rallepalaveev/AppleII-VGA/A2VGA2/HW/A2VGA.v2.1.jpeg

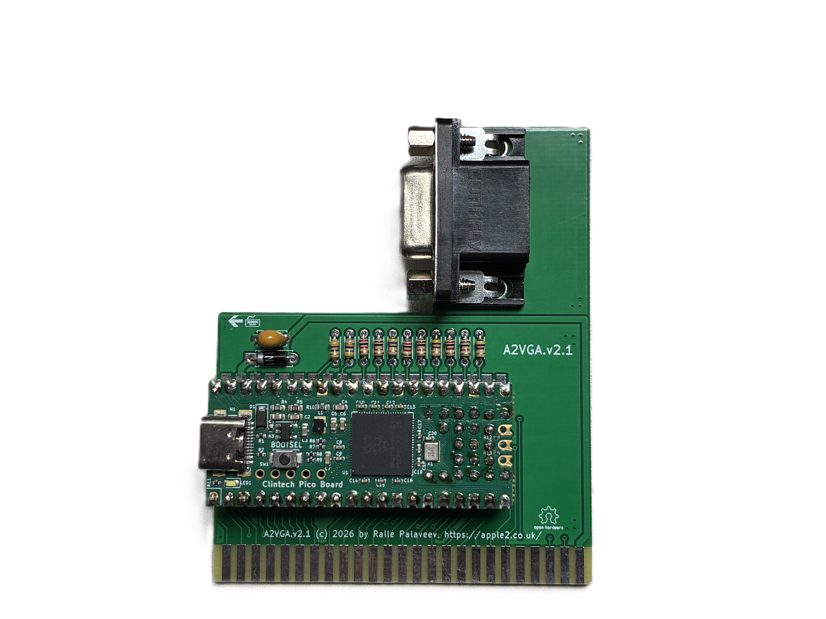
A2VGA2/HW/A2VGA.v2.1.jpeg
