rallepalaveev/AppleII-VGA/A2VGA2/README.md

This is a redesign of the Apple II VGA based on the PR2350 chip with 48 GPIOs (on Clintech Pico Board) which is 5V tolerant and hence no trinsceivers would be needed.

The A2VGA2 hardware design is released under the MIT License:

    Board design by Ralle Palaveev, Copyright (c) 2026.

    Firmware adaptation for RP2350 by Oliver Schmidt, Copyright (c) 2026.

The firmware project would be based on awesome work from the following Apple II VGA project:

    AppleII-VGA. MIT License. Copyright (c) 2021-2022 Mark Aikens.
