rallepalaveev/AppleII-VGA/A2VGA2/HW/A2VGA.v2.0.pdf

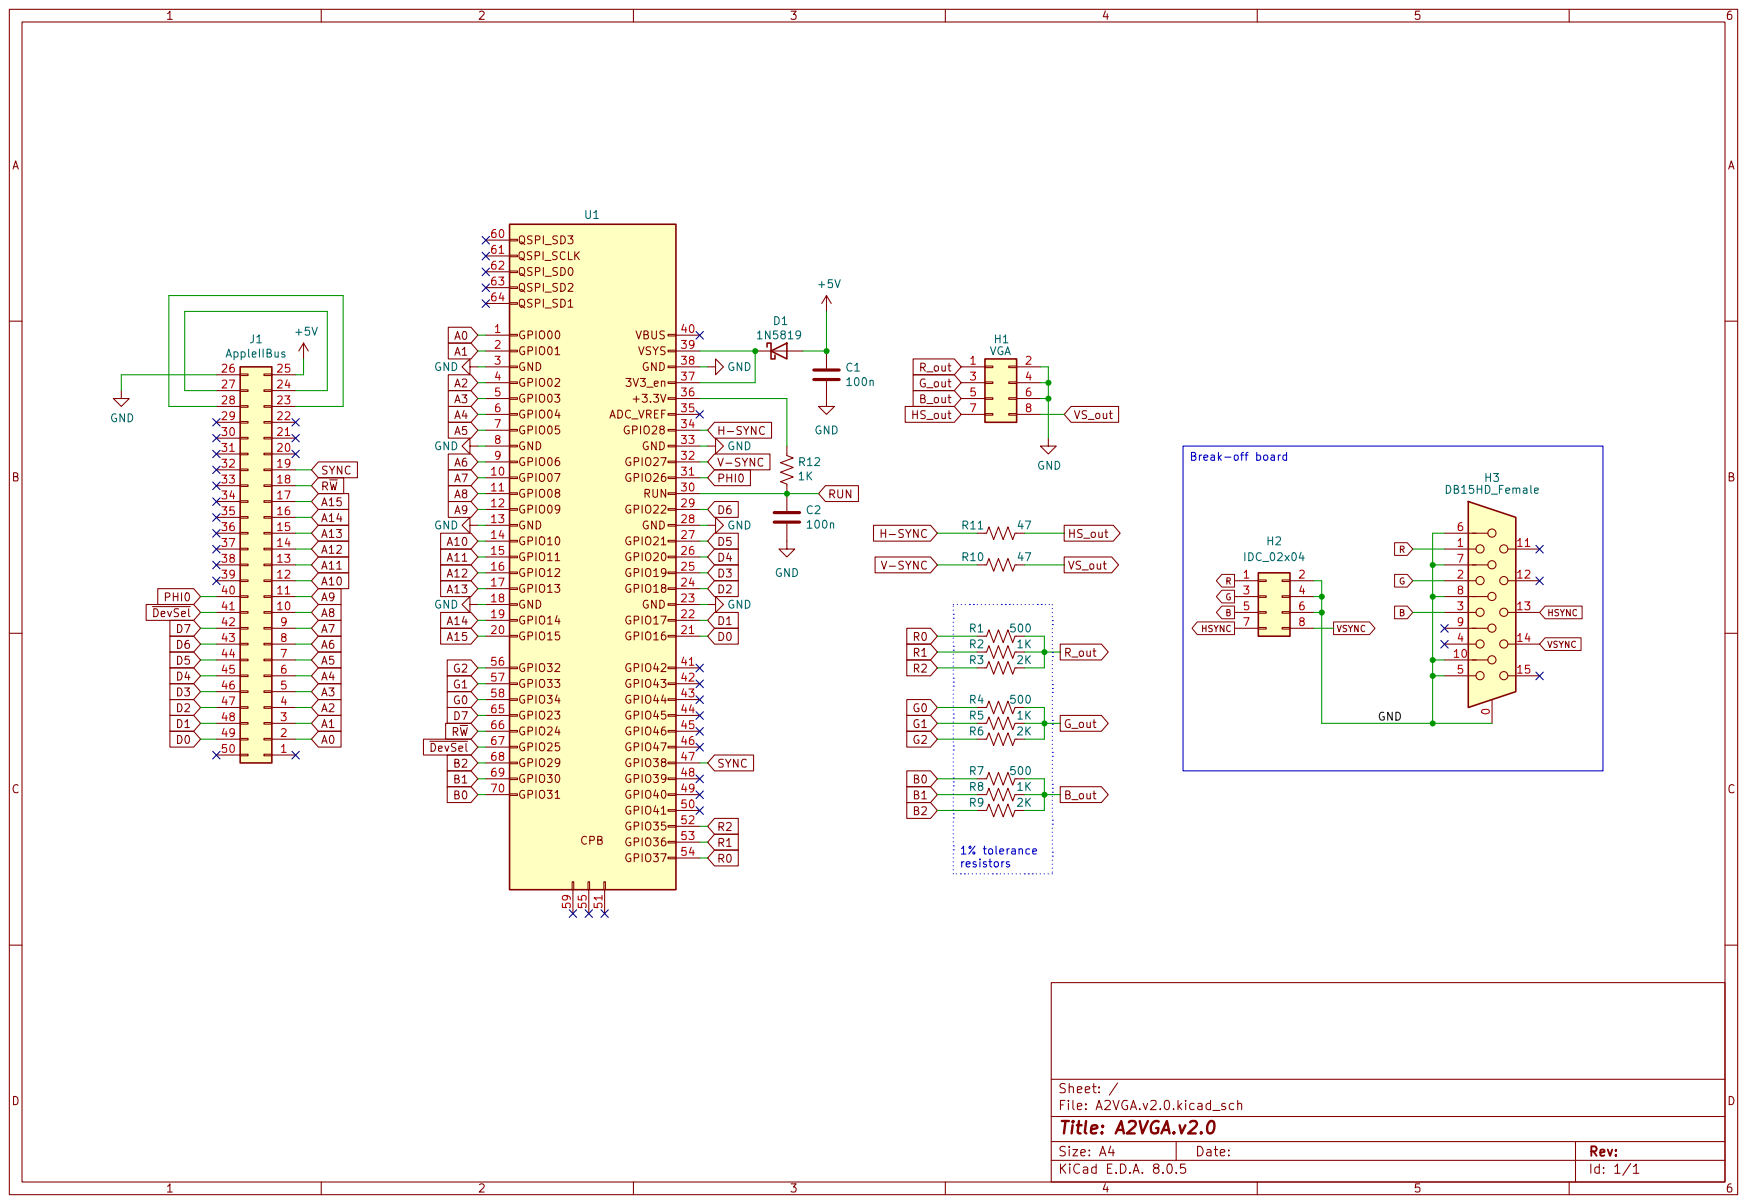
[picture p2: page 1]
