rallepalaveev/AppleII-VGA/A2VGA2/HW/A2VGA.v2.0.kicad_pcb

## KiCad design A2VGA2/HW/A2VGA.v2.0.kicad_pcb (2026-08-10, an earlier design)

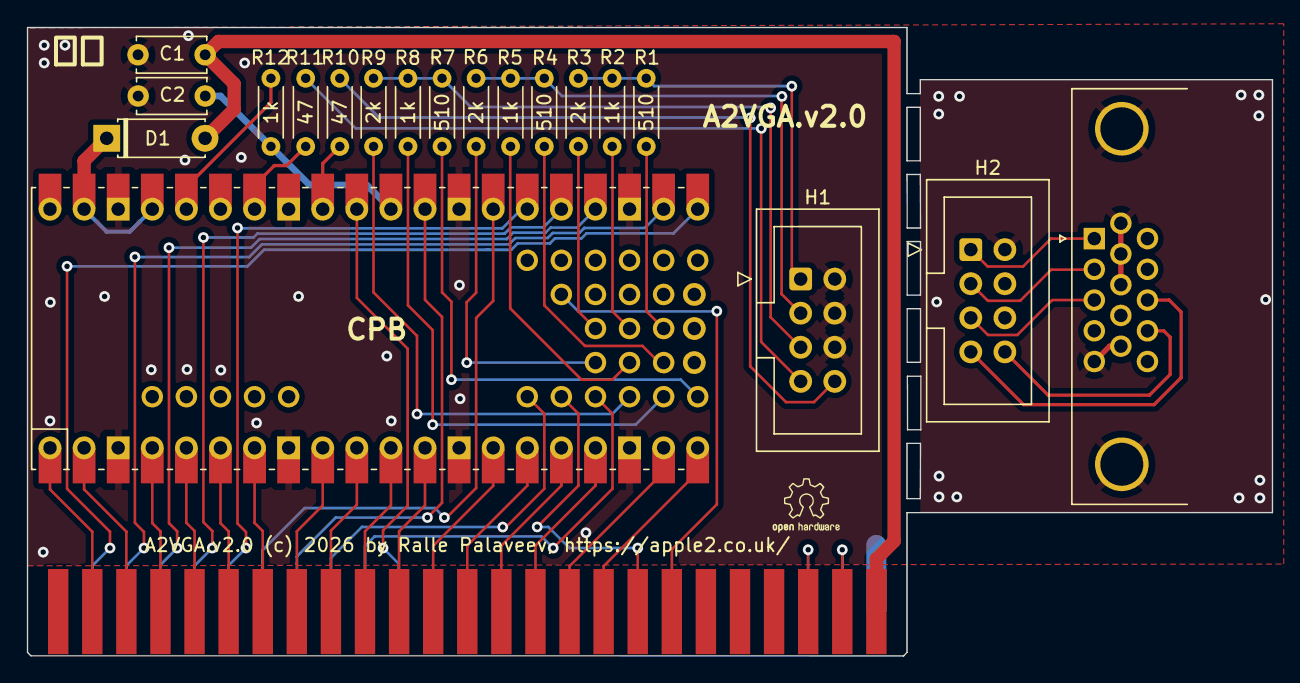
[picture p3: board A2VGA.v2.0.kicad_pcb from above]

Board: 2 copper layers, 92.8 x 46.8 mm, 19 parts (0 on the bottom side), 21 nets.

Parts:
C1, C2: 100n; C_Disc_D5.0mm_W2.5mm_P5.00mm
D1: D_T-1_P5.08mm_Horizontal
H1, H2: IDC-Header_2x04_P2.54mm_Vertical
H3: DB15_Female_HighDensity_MountingHoles; DSUB-15-HD_Female_Horizontal_P2.29x1.98mm_EdgePinOffset3.03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
R1, R4, R7: 510; R_Axial_DIN0204_L3.6mm_D1.6mm_P5.08mm_Horizontal
R2, R5, R8, R12: 1k; R_Axial_DIN0204_L3.6mm_D1.6mm_P5.08mm_Horizontal
R3, R6, R9: 2k; R_Axial_DIN0204_L3.6mm_D1.6mm_P5.08mm_Horizontal
R10, R11: 47; R_Axial_DIN0204_L3.6mm_D1.6mm_P5.08mm_Horizontal
U1: CPB; CPB_SMD_TH

Connections:
3.3V: R12.1, U1.36
5V: C1.2, D1.2
B0: R7.2, U1.70
B1: R8.2, U1.69
B2: R9.2, U1.68
B_out: H1.5, H2.5, H3.3, R7.1, R8.1, R9.1
G0: R4.2, U1.58
G1: R5.2, U1.57
G2: R6.2, U1.56
GND: C1.1, C2.1, H1.2, H1.4, H1.6, H2.2, H2.4, H2.6, H3.0, H3.5, H3.6, H3.7, H3.8, H3.10, U1.3, U1.8, U1.13, U1.18, U1.23, U1.28, U1.33, U1.38
G_out: H1.3, H2.3, H3.2, R4.1, R5.1, R6.1
HSYNC: R11.2, U1.34
HS_out: H1.7, H2.7, H3.13, R11.1
R0: R1.2, U1.54
R1: R2.2, U1.53
R2: R3.2, U1.52
RUN: C2.2, R12.2, U1.30
R_out: H1.1, H2.1, H3.1, R1.1, R2.1, R3.1
VSYNC: R10.2, U1.32
VSYS: D1.1, U1.37, U1.39
VS_out: H1.8, H2.8, H3.14, R10.1
