rallepalaveev/AppleII-VGA/(commit log)

2026-06-27 Adjust firmware for the recently added RP2354B based A2VGA2 board
    The RP2354B is 5v tolerant on most pins and has (actually more than) enough pins to directly connect both the A2 slot bus as well as the VGA connector. Therefore the 245 buffers aren't necessary anymore. This simplifies the firmware as it doesn't have to drive the three buffers to perform A2 slot bus pin multiplexing. Rather it can read the just read the pins as it sees fit.
    [abus.c, board_config.h, main.c, vga.c]
2026-06-27 temporary hack to allow linking for all RP Pico variants
2026-07-21 Fix bugs for the recently added A2VGA2 board
    [abus.c]
2026-07-22 Make use of Clintech Pico Board header file
2026-07-22 Use the Clintech Pico Board specific macro to identify the A2VGA2 board
2026-07-22 Avoid code duplication by adding two macros
    [abus.c, board_config.h]
2026-07-22 Don't try to use the LED on the Clintech Pico Board
    The GPIO the LED is connected to, is used for other purposes on the A2VGA2 board.
2026-07-24 Update A2VGA.v2.0.kicad_pcb file
    [A2VGA.v2.0.kicad_pcb]
2026-07-24 Update A2VGA.v2.1.kicad_pcb file
    [A2VGA.v2.1.kicad_pcb]
2026-10-10 Removed local Clintech Pico Board header
    That header is now part of the official Pico SDK.
