rallepalaveev/AppleII-VGA/(notices)

Notices in the files:
A2VGA2/HW/A2VGA.v2.1.kicad_pcb:
Board design by Ralle Palaveev, (c) 2026
Firmware by Oliver Schmidt, (c) 2026
Based on work by:
AppleII-VGA, Mark Aikens (c) 2021-2023
A2VGA.v2.1 (c) 2026 by Ralle Palaveev, https://apple2.co.uk
A2VGA2/HW/A2VGA.v2.0.kicad_pcb:
A2VGA.v2.0 (c) 2026 by Ralle Palaveev, https://apple2.co.uk
A2VGA2/HW/A2VGA.v2.2.kicad_pcb:
A2VGA.v2.2 (c) 2026 by Ralle Palaveev, https://apple2.co.uk
